sbbxiii/rule-based-line-follower/paper/README.md

# 📄 Project Paper & Academic Report

This directory contains the project research report documenting the engineering design, mathematical formulation, control implementation, and empirical kinematic analysis of the robot.

---

## 📌 Document Status & Context

> [!NOTE]
> **Status: Unpublished Academic Engineering Report**  
> This paper is an **unpublished university project report** developed for an internal robotics competition at the **Department of Mechatronics, University of Debrecen (Debrecen, Hungary)**. It is archived here strictly for portfolio documentation and educational purposes. It is **not** published in a journal or conference proceedings.

---

## 👥 Co-Authors & Affiliation

All research, fabrication, and experimental validation were carried out by the team members at:  
**Department of Mechatronics, Faculty of Engineering, University of Debrecen**

- **Azar Animon**
- **Malak Hiba**
- **David Pani**
- **John Stephen Barka**
- **Nmesoma Chukwukadibia Osakwe**

---

## 📑 Document File

- **File**: [`Building_a_Rule_Based_Line_Follower_Robot.pdf`](Building_a_Rule_Based_Line_Follower_Robot.pdf)
- **Title**: *Building a Rule-Based Line Follower Robot: Design, Testing, and Performance Insights*
- **Contents**:
  1. Introduction & Theoretical Foundations (Rule-Based vs. PID vs. Fuzzy Logic)
  2. Methodology & Hardware Selection
  3. Electronic Circuitry & Power Distribution (EasyEDA schematic)
  4. Mechanical Design & Weight Distribution Trade-offs
  5. Rule-Based Mathematical State Formulation ($S \in \{0, 1\}^5$, $f: S \to A$, $g: A \to \mathbb{Z}^4$)
  6. Multi-Feature Test Track Architecture
  7. Empirical Scenario Evaluation
  8. Kinovea 2D Video Motion Kinematic Analysis (Distance, Velocity, and Acceleration profiling)
  9. Discussion, Hardware Limitations, and Future Adaptations
