sbbxiii/rule-based-line-follower/media/initial_logic_flowchart.png

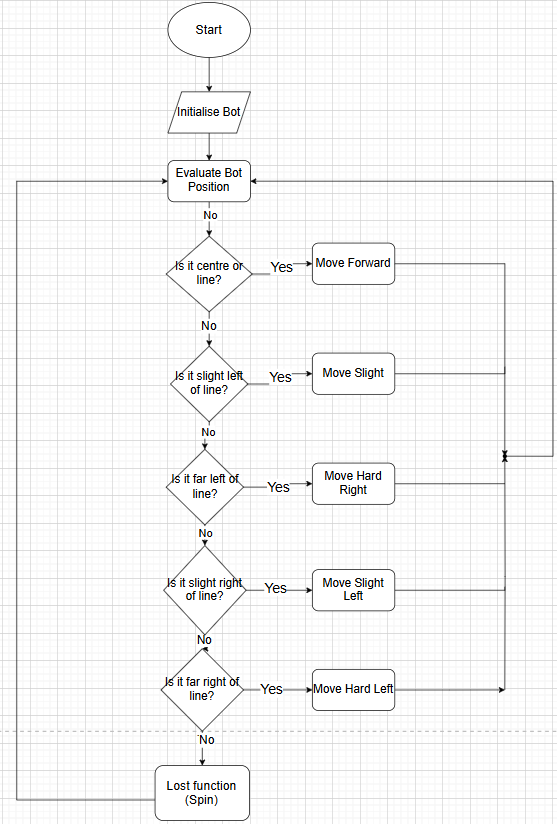
media/initial_logic_flowchart.png
